u1F992/3xtDS/kicad/receiver/receiver.kicad_pcb

## KiCad design kicad/receiver/receiver.kicad_pcb (2023-05-04)

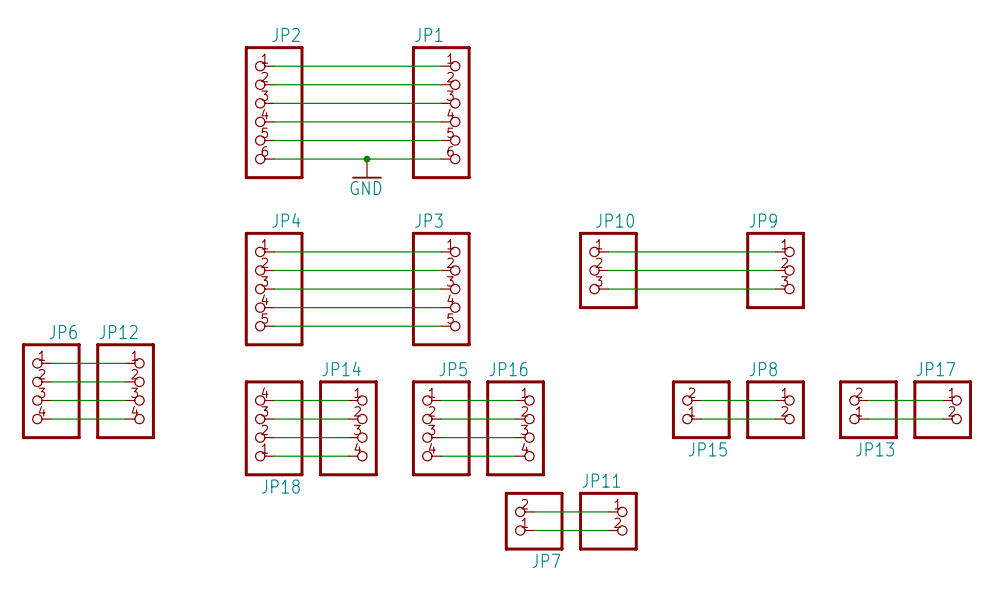
[picture p7: schematic receiver.kicad_sch]

Parts:
JP1, JP2: PINHD-1X6; 1X06
JP3, JP4: PINHD-1X5; 1X05
JP5, JP6, JP12, JP14, JP16, JP18: PINHD-1X4; 1X04
JP7, JP8, JP11, JP13, JP15, JP17: PINHD-1X2; 1X02
JP9, JP10: PINHD-1X3; 1X03

Connections:
GND: JP1.6, JP2.6
unnamed: JP1.1, JP2.1
unnamed: JP1.2, JP2.2
unnamed: JP1.3, JP2.3
unnamed: JP1.4, JP2.4
unnamed: JP1.5, JP2.5
unnamed: JP8.1, JP15.2
unnamed: JP3.1, JP4.1
unnamed: JP3.2, JP4.2
unnamed: JP3.3, JP4.3
unnamed: JP3.4, JP4.4
unnamed: JP3.5, JP4.5
unnamed: JP8.2, JP15.1
unnamed: JP7.2, JP11.1
unnamed: JP7.1, JP11.2
unnamed: JP6.1, JP12.1
unnamed: JP6.2, JP12.2
unnamed: JP6.3, JP12.3
unnamed: JP6.4, JP12.4
unnamed: JP5.1, JP16.1
unnamed: JP9.1, JP10.1
unnamed: JP9.2, JP10.2
unnamed: JP9.3, JP10.3
unnamed: JP5.2, JP16.2
unnamed: JP5.3, JP16.3
unnamed: JP5.4, JP16.4
unnamed: JP14.1, JP18.4
unnamed: JP14.2, JP18.3
unnamed: JP14.3, JP18.2
unnamed: JP14.4, JP18.1
unnamed: JP13.2, JP17.1
unnamed: JP13.1, JP17.2

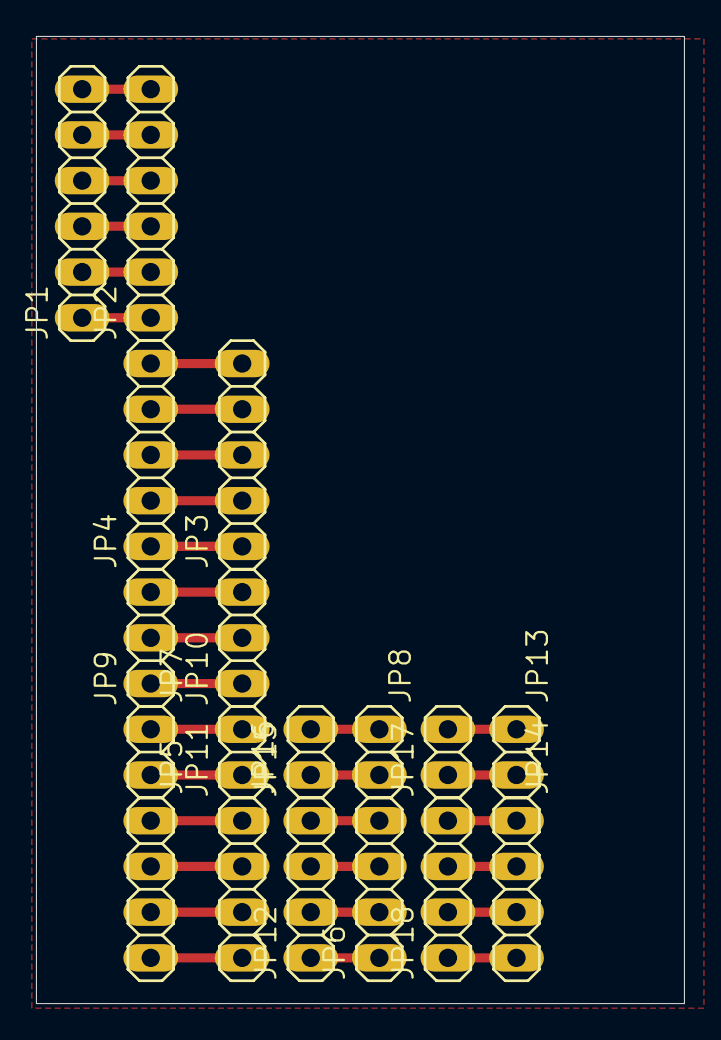
[picture p8: board receiver.kicad_pcb from above]

Board: 2 copper layers, 36.0 x 53.7 mm, 18 parts (0 on the bottom side), 32 nets.
