u1F992/3xtDS/kicad/control_board/control_board.kicad_pcb

## KiCad design kicad/control_board/control_board.kicad_pcb (2023-05-04)

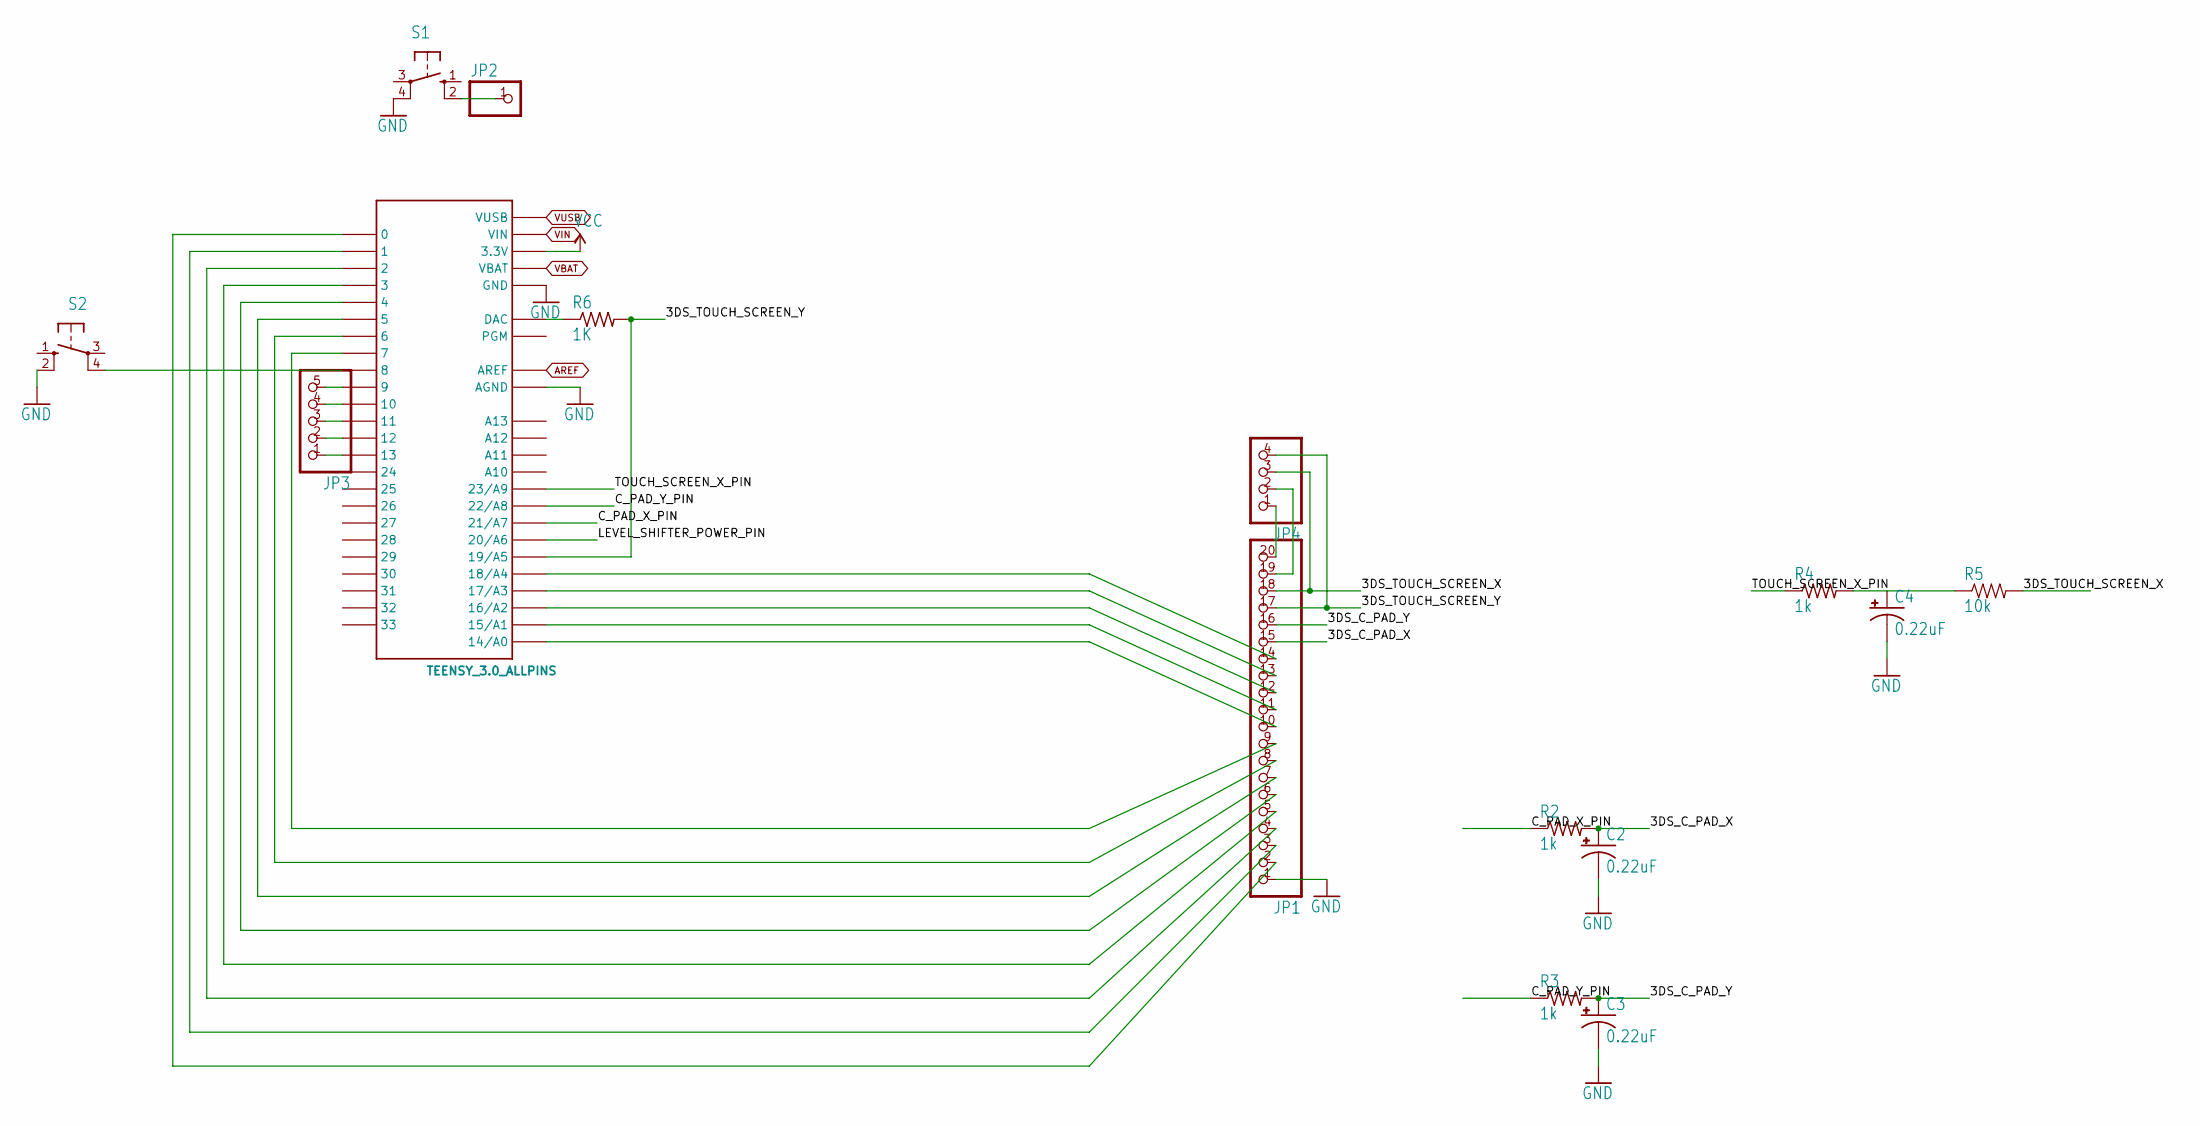
[picture p9: schematic control_board.kicad_sch]

Parts:
C2, C3, C4: 0.22uF; CPOL-RADIAL-10UF-25V
JP1: PINHD-1X20; 1X20
JP2: PINHD-1X1; 1X01
JP3: PINHD-1X5; 1X05
JP4: PINHD-1X4; 1X04
R2, R3, R4: 1k; 0207_7
R5: 10k; AXIAL-0.1
R6: 1K; 0207_7
S1, S2: 10-XX; B3F-10XX
U$1: TEENSY_3.0_ALLPINS

Connections:
3DS_C_PAD_X: C2.1 (+), JP1.15, R2.2
3DS_C_PAD_Y: C3.1 (+), JP1.16, R3.2
3DS_TOUCH_SCREEN_X: JP1.18, JP4.3, R5.P$2 (2)
3DS_TOUCH_SCREEN_Y: JP1.17, JP4.4, R6.2, U$1.19/A5
AREF: U$1.AREF
C_PAD_X_PIN: R2.1, U$1.21/A7
C_PAD_Y_PIN: R3.1, U$1.22/A8
GND: C2.2 (-), C3.2 (-), C4.2 (-), JP1.1, S1.4 (P1), S2.2 (S1), U$1.AGND, U$1.GND, U$1.GND1 (GND), U$1.GND2 (GND)
LEVEL_SHIFTER_POWER_PIN: U$1.20/A6
unnamed: JP2.1, S1.2 (S1)
unnamed: JP1.10, U$1.14/A0
unnamed: JP1.11, U$1.15/A1
unnamed: JP1.12, U$1.16/A2
unnamed: JP1.13, U$1.17/A3
unnamed: JP1.2, U$1.0
unnamed: JP1.3, U$1.1
unnamed: JP1.4, U$1.2
unnamed: JP1.5, U$1.3
unnamed: JP1.6, U$1.4
unnamed: JP1.7, U$1.5
unnamed: JP1.8, U$1.6
unnamed: JP1.9, U$1.7
unnamed: R6.1, U$1.RESET (DAC)
unnamed: JP1.14, U$1.18/A4
unnamed: JP3.5, U$1.9
unnamed: JP3.4, U$1.10
unnamed: JP3.3, U$1.11
unnamed: JP3.2, U$1.12
unnamed: JP3.1, U$1.13
unnamed: JP1.20, JP4.1
unnamed: JP1.19, JP4.2
unnamed: S2.4 (P1), U$1.8
TOUCH_SCREEN_X_PIN: R4.1, U$1.23/A9
VBAT: U$1.VBAT
VCC: U$1.3.3V, U$1.3.3V1 (3.3V), U$1.3.3V2 (3.3V)
VIN: U$1.VIN
VUSB: U$1.VUSB

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
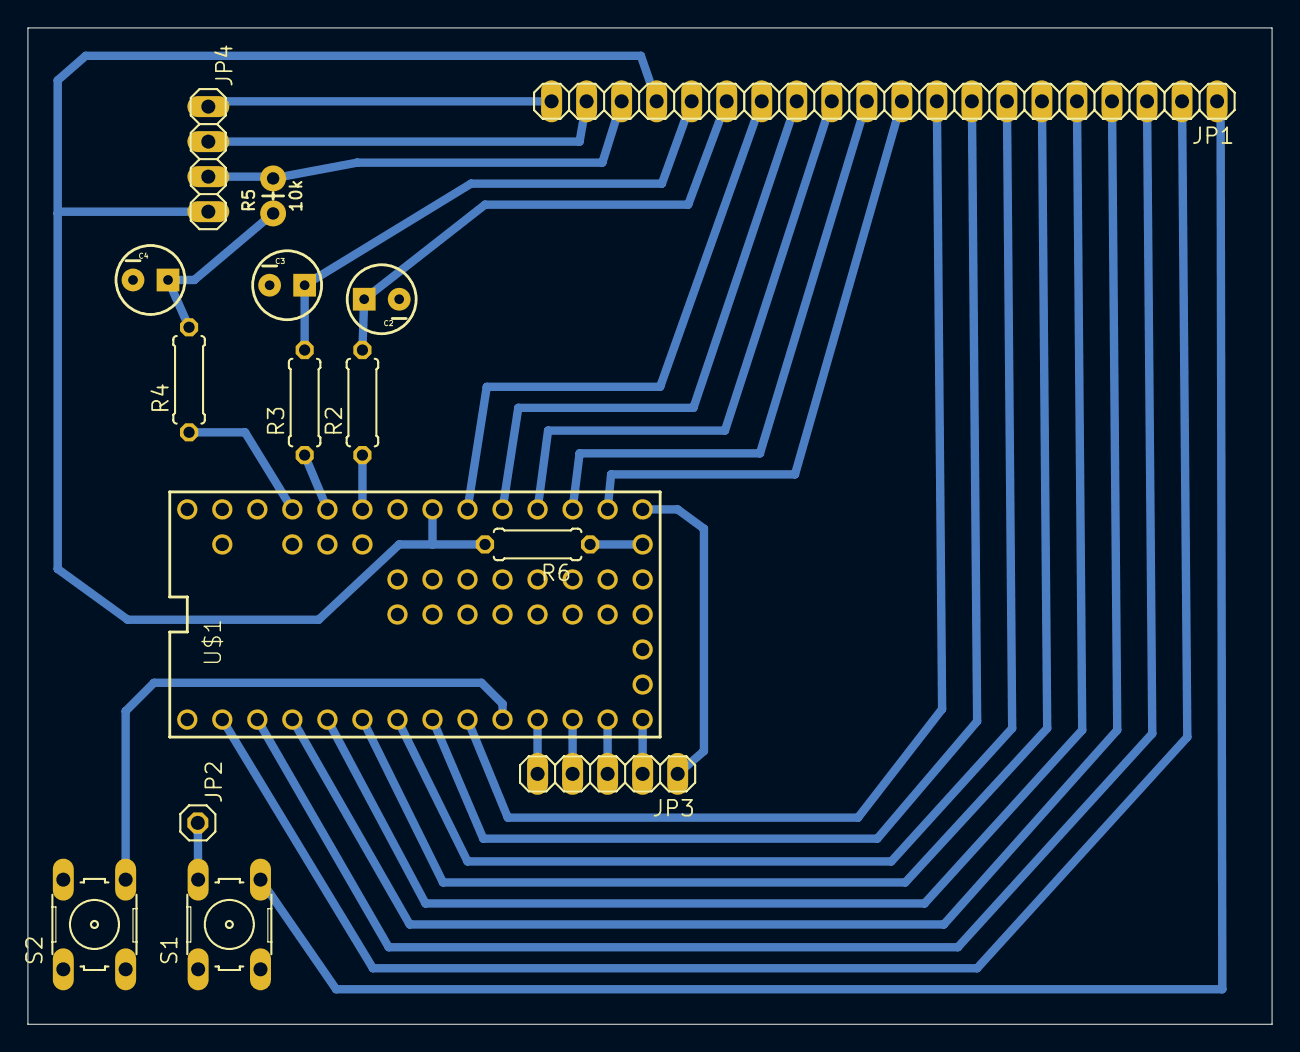
[picture p10: board control_board.kicad_pcb from above]

Board: 2 copper layers, 90.2 x 72.3 mm, 15 parts (0 on the bottom side), 33 nets.
